colbyjohnson1994/EdenPURE-500XL---Mods/cad/EdenPure500XL-PCB Spacers v1.stl

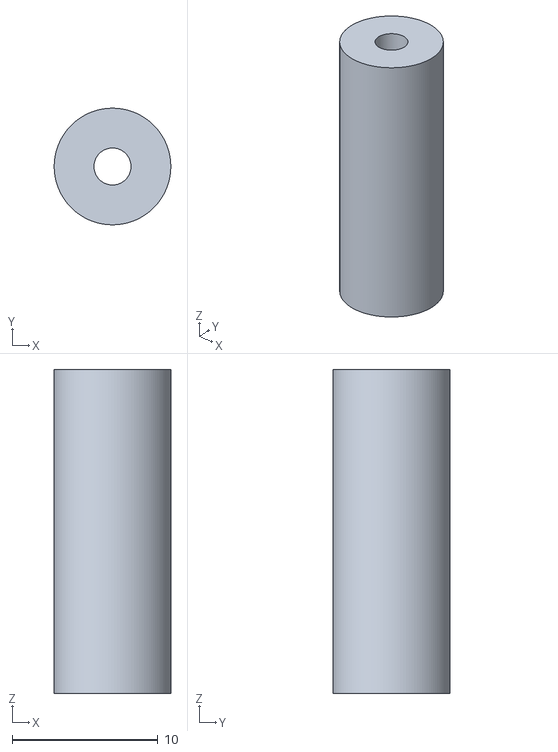
[picture p1: CAD file, 2024-06-02]
cad/EdenPure500XL-PCB Spacers v1.stl
8.00 x 8.00 x 22.2
