colbyjohnson1994/EdenPURE-500XL---Mods/(commit log)

2024-05-03 MCC generated code complete
    Pin definitions have been created
    2 timers (one for LED/button state machine and the second for heat state)
    readme updated for C code to remember code setup in mplab
2024-05-04 Preparing firmware for write
    Added TX EUSART for debugging purposes (will power board with DC to test UI and buttons)
    Changed logic ISR timer to being 100 ms and count, that way we can use this timer for multiple purposes.
    Starting to framework out the variables and functions we will need to run the heater.
    Trying to comment as much as possible as I go to prevent needing to come back later and tackle documentation.
    [functions.h]
2024-05-21 Untested Theoretical Code
    All major functions are written in now. Took a break for a week to catch up on other projects. Need to put chip into board and test out changes.
    Pullup resistor was added to board on PIN 3 of micro, due to lack of internal WPU on that particular pin.
2024-05-24 CHIP CHANGE
    Got working NTC calculations and also had to make a change to the schematic (for clarity on which pin was high and low on the NTC).
    Once this was working I discovered i had 99% program usage even with custom log functions to save space. I moved this project to PIC16F1847 which has double the program memory which I will need.
2024-05-30 Many Functions Working, EXCEPT EEPROM!
    Heat logic, button, LED's, state machines, speaker (different tones based on button press) all working. EEPROM is not working across power cycles, but works when writing then reading back? Need to investigate
    [functions.h, main.c]
2024-06-02 EEPROM working!
    It was a dumb issue. Forgot to set _SaveMemory flag to actually save the data when buttons are clicked.
    New unreleated problem...spacers that hold PCB to back cover all broke off. Will design 3dprinted spacer that is a through spacer.
    [main.c, variables.h]
2024-06-02 Added STL file for PCB spacers
    PCB spacers needs to mount the PCB since all spacers broke off.
    [EdenPure500XL-PCB Spacers v1.stl]
